uofu-emb-26/Autonomous-Sailboat/docs/main.pdf

# ALAN: Autonomous Long-Range Aquatic Navigation Vessel

(The V is silent.)

Charbel Salloum, Connor Stevens, Corbin Barney, Harrison LeTourneau, Jared Pratt

Abstract—This paper describes the design and implementation of ALAN (Autonomous Long-Range Aquatic Navigation), a semi-autonomous sailboat intended for longduration operation in open water environments. The vessel navigates between user-defined waypoints using windpowered propulsion, requiring no human intervention during transit. This work addresses the challenge of building a low-cost autonomous sailing platform suitable for environmental monitoring and oceanographic data collection, where conventional motorized vessels are limited by fuel capacity and operational cost. The mechanical, electrical, and software subsystems are presented, along with an analysis of associated risks and mitigation strategies.

I. INTRODUCTION

Autonomous marine vessels have the potential to revolutionize environmental monitoring, oceanographic data collection, and maritime logistics by eliminating the need for crewed expeditions. However, existing solutions are often prohibitively expensive, reliant on motor-driven propulsion with limited range, or lack the robustness required for extended blue water operation. A low-cost, sail-powered autonomous vessel would enable persistent ocean presence for data collection without the fuel constraints and maintenance overhead of motorized platforms.
Several approaches to autonomous sailing have been explored in both academic and commercial domains. The SailBot competition community has produced numerous small-scale autonomous sailboats, typically using cloth sails with servo-actuated sheets. Commercial efforts such as Saildrone employ rigid wingsails on large platforms for ocean research. University projects have explored various hull configurations, sail types, and control algorithms ranging from simple reactive controllers to machine learning approaches.
Prior autonomous sailboat projects have demonstrated the viability of GPS waypoint navigation combined with wind-aware path planning. The self-trimming wingsail concept, where a tail vane provides passive torque to rotate the main sail element, has been shown to minimize power consumption compared to motor-actuated sail systems. Trimaran hull designs offer superior stability over monohulls, which is critical for sensor platforms that must remain upright in varying sea states.
ALAN (Autonomous Long-Range Aquatic Navigation) is a semi-autonomous trimaran sailboat that navigates between user-defined waypoints without human intervention. The vessel employs a self-trimming rigid wingsail for propulsion, minimizing power draw while maximizing aerodynamic efficiency. A dual-core STM32H755 microcontroller running FreeRTOS manages real-time sensor fusion (GPS, IMU, magnetometer, wind vane) and control loops for rudder actuation. Long-range communication is achieved via LoRa radio at 915 MHz, enabling telemetry uplink and route update downlink from a ground station.
The scope of this project includes:
- Hull design and fabrication
- Keel and rudder construction
- Rigid wingsail with self-trimming mechanism
- Sensor integration for navigation and orientation
- Long-range wireless communication
- Embedded firmware for autonomous waypoint navigation
Excluded from scope are solar charging, full blue-water endurance testing, and machine-learning-based control. At Demo Day, the vessel will demonstrate autonomous navigation between a series of waypoints on open water (This will be done before hand and displayed using video).

II. SAFETY, GLOBAL, SOCIETAL, ETHICAL CONSIDERATIONS

The ALAN vessel operates autonomously on open water, presenting potential hazards to other watercraft, swimmers, and marine wildlife. To mitigate collision risk, the vessel will be limited to small, controlled bodies of water during testing and will transmit its GPS position continuously via LoRa for ground station monitoring. The vessel’s low speed (sail-powered) and small size reduce the severity of any potential impact. Emergency recovery procedures allow the ground station operator to override autonomous control at any time.
An autonomous sailboat is inherently environmentally friendly compared to motor-driven alternatives. Wind propulsion produces zero emissions and zero noise pollution underwater. The vessel uses a lithium-ion battery only for electronics, not propulsion, minimizing energy consumption. Materials selection (fiberglass, stainless steel, PLA) avoids toxic substances that could leach into water.
Autonomous ocean monitoring platforms could democratize marine research by reducing the cost of data collection expeditions. Developing nations with extensive coastlines but limited research budgets could benefit significantly from low-cost autonomous sailing platforms. However, care must be taken to ensure that such technology is not misused for illicit activities (e.g., smuggling) or deployed in protected marine areas without proper authorization.
The project demonstrates that autonomous sailing vessels can be constructed at a fraction of the cost of commercial alternatives. Currently the only custom part is the hull and its associated components. By using offthe-shelf components (STM32 dev boards, commodity sensors, etc.), the total bill of materials remains accessible to other university teams and hobbyist developers. As engineers, the team has an obligation to ensure the vessel cannot cause harm to people or the environment. This includes implementing fail-safe behaviors (returnto-home on communication loss), clearly marking the vessel as unmanned, and operating only in permitted waterways. Data collected by onboard sensors will be handled responsibly, and the communication protocol will not interfere with other ISM band users beyond regulatory limits.

III. MECHANICAL TASKS

A. Hull

The hull is a trimaran design with a displacementtype main hull (vaka) and two outrigger hulls (amas) connected by arms. The trimaran configuration provides superior stability—the amas act as counterbalances during heeling, preventing capsize.
Fabrication: The hull is manufactured via fiberglass wet layup in a two-part female mold (bow and stern halves, bolted together). The mold is 3D-printed in standard PLA and surface-finished with Rustoleum filler primer, SprayMax 2K topcoat, PARTALL paste wax, and PVA film release agent. Seven sheets of 4 oz plainweave fiberglass cloth are laid up with TotalBoat 5:1 marine epoxy resin, yielding approximately 1 mm wall thickness. The keel mounting area receives additional fiberglass layers and an embedded metal plate bonded with resin for structural reinforcement. The stern is similarly reinforced and fitted with a removable mounting plate for rudder installation. The deck will be fabricated from foam separately and bonded to the hull after curing, allowing for easier access to the interior during assembly. Responsible: Harrison LeTourneau.
Completed Tasks: Hull mold printed and surface-finished; fiberglass layup complete.
Pending Tasks: Mounting hardware installation; deck fabrication and bonding; final sanding; balancing and weight distribution adjustments; static float testing.
B. Sail
The sail is a self-trimming rigid wingsail consisting of a main sail element and a tail mounted aft on a long rod. The tail provides passive aerodynamic torque to rotate the main sail to the optimal angle of attack relative to the wind, minimizing power consumption compared to motor-actuated designs.
Fabrication: The main sail and tail are carved from XPS rigid foam board and covered in fiberglass for durability. The mast is a 3 ft section of 6061 aluminum round tube, mounted on a bearing at the deck to allow free rotation. A servo housed inside the sail body drives tail rotation via wire linkage, providing the self-trimming function.
Responsible: Charbel Salloum, Connor Stevens. Completed Tasks: Foam shaping.
Pending Tasks: Fiberglass covering; servo integration; linkage fabrication; mounting hardware installation.
C. Rudder
The rudder is a spade-type design, chosen for simplicity and ease of modification. It is free-floating (not attached to a skeg), which simplifies construction at the cost of reduced protection from debris impact. Fabrication: The rudder shaft is a 304 stainless steel round bar (0.25 in. × 12 in.) with a 3D printed rudder plate that clamps around the bar. It mounts to the stern via a fore/aft clamp mechanism using two rear mounting plates (Aluminium, 0.065 in.) secured with 1/4-20 hex bolts, nylon insert lock nuts, and stainless washers. Ceramic ball bearings (R188, 1/4 × 1/2 × 3/16 in.) enable free rotation. A DS3218 MG digital servo drives the rudder via a 25-tooth spline-to-1/4-in. shaft coupler. Responsible: Corbin Barney, Jared Pratt.
Completed Tasks: Rudder shaft and plate fabricated. Pending Tasks: Bearing installation; mounting hardware installation; servo integration; linkage fabrication.

D. Keel
The keel is a fin keel with a weighted bulb, chosen for manufacturability and effective center-of-mass control. The fin provides lateral resistance (generating keel lift to counteract sail lift), while the bulb lowers the center of gravity for improved stability.
Fabrication: The keel frame uses 304 stainless steel— a square bar post (0.5 in. × 7 in.) with plate mounting brackets. Two mirrored PLA fins are clamped around the square post and secured with 3/16-in. binding posts. The bulb is a 304 SS round tube (2 in. × 8.5 in.) filled with up to 2 kg of steel balls for ballast. The assembly is wrapped in fiber glass with epoxy resin for structural rigidity.
Responsible: Corbin Barney, Jared Pratt.
Completed Tasks: Keel post and mounting brackets fabricated; fin molds printed.
Pending Tasks: Fin layup; mounting hardware installation.
E. Complete Boat
Integration of hull, keel, rudder, and sail subsystems requires careful alignment of mounting points and verification of center of effort (COE) and center of lateral resistance (CLR) positioning. The COE (where sail lift acts) should be slightly aft of the CLR (where keel lift acts) to achieve weather helm—a natural tendency to turn into the wind that improves stability and safety. We will also need to ensure the rudder has sufficient authority to counteract the aerodynamic forces on the sail, which may require adjusting the rudder size or position after initial testing. Finally, the vessel will be balanced by adjusting the amount of ballast in the keel bulb and the distribution of weight within the hull to achieve the desired waterline, freeboard, and beam rock characteristics.
Testing: Static float tests will verify waterline, freeboard, and draft. Tow tests will confirm rudder authority and directional stability before autonomous operation. Weight distribution will be adjusted by repositioning steel ballast in the keel bulb.
Responsible: ALAN Team.

IV. ELECTRICAL TASKS

A. LoRa
Long-range communication between the vessel and ground station uses LoRa (Long Range) radio operating at 915 MHz in the ISM band (North America). LoRa’s sub-GHz frequency provides significantly greater range than WiFi or Bluetooth due to reduced free-space path loss and better diffraction around obstacles.

Hardware: The vessel carries an Adafruit RFM95W LoRa transceiver breakout board. The ground station uses an Adafruit Feather RP2040 with integrated RFM95 LoRa radio. Both endpoints use 10 dBi whip antennas connected via SMA-to-uFL adapter cables for maximum range. A 5 ft SMA extension cable is used to place the antenna on the top of the vessel’s sail for improved lineof-sight.
Protocol: Uplink (vessel to ground) transmits servo positions, sensor readings, battery state, and GPS coordinates. Downlink (ground to vessel) sends manual control overrides or route/waypoint updates.
Responsible: LoRa Team.
Completed Tasks: LoRa hardware procured; basic communication established.
Pending Tasks: Implement robust packet structure with error checking; integrate LoRa communication into main firmware; test range and reliability in open water conditions.
B. Servos
Two servo motors (DS3218 MG Digital Servo, waterproof, high-torque) actuate the vessel’s control surfaces. The rudder servo controls heading via the rudder shaft coupler. The wingsail servo is housed inside the wingsail to drive tail rotation for self-trimming.
Both servos are powered from the power distribution board at appropriate voltage levels and controlled via PWM signals from the STM32H7.
Responsible: Sensor Team.
Completed Tasks: Servos procured; basic PWM control tested.
Pending Tasks: Implement closed-loop control for rudder and sail angle; test servo response under load conditions.
C. Sensors
The vessel integrates the following sensors for navigation and state awareness:
- GPS (NEO-6 module): Provides latitude/longitude for waypoint navigation. Communicates via UART.
- 9-DoF IMU & Magnetometer (BNO055): Provides spatial orientation (roll, pitch, yaw) and magnetic heading. Used for attitude estimation and heading hold between GPS fixes.
- Wind Vane Direction Sensor (DFRobot): Measures apparent wind direction relative to the vessel. Critical for sail angle optimization and tacking decisions. Communicates via RS485 (adapted to UART via RS485-to-UART converter). Responsible: Sensor Team.

Completed Tasks: Sensors procured; basic communication established; sensors calibrated on the bench. Pending Tasks: Integrate sensor readings into main firmware; implement sensor fusion for accurate state estimation; test sensor performance in marine environment.

D. MCU
The central processor is the STM32H755ZIT6, a dual-core microcontroller featuring a Cortex-M7 core (480 MHz) and a Cortex-M4 core (240 MHz). Two development boards are available for development and a spare.
Architecture: The CM7 core handles real-time control loops (sensor fusion, PID control, servo actuation) and will run on FreeRTOS. The CM4 core handles communication (LoRa packet assembly/parsing, telemetry logging) and runs on bare metal. The two cores communicate via shared memory and inter-core interrupts. Firmware: Written in C using STM32 HAL drivers. The project uses CMake for build management. Responsible: Embedded Team.
Completed Tasks: Basic FreeRTOS setup on CM7; CM7 sensor reading and control loop tested; CM4 LoRa communication tested.
Pending Tasks: Optimize task scheduling and inter-core communication.
E. RC Boat
To prove the functionality of the mechanical and electrical subsystems before autonomous integration, we will build and equip the boat with a manual override and RC system. This will allow us to test the hull, keel, rudder, and sail in real-world conditions while manually controlling the vessel via LoRa communication. The RC system will be integrated with the existing servos and power distribution, allowing us to switch between manual and autonomous control modes for testing and demonstration purposes at a later stage.
Responsible: ALAN Team.
Completed Tasks: RC components procured; basic manual control tested outside of the boat.
Pending Tasks: Integrate RC control with existing servos and power system in the boat; test manual control in open water conditions.
V. SOFTWARE TASKS
A. Positioning
The positioning subsystem fuses GPS and IMU data to determine the vessel’s position and heading at all times. GPS provides absolute position at low update rates, while the IMU and magnetometer provide high-rate heading and attitude information between GPS fixes. Implementation: A complementary filter combines GPS position with integrated IMU acceleration and magnetometer heading to produce a smooth, accurate state estimate. The system must handle GPS dropouts gracefully by dead-reckoning from IMU data until GPS lock is reacquired.
Responsible: Corbin Barney, Harrison LeTourneau. Completed Tasks: None.
Pending Tasks: Implement sensor fusion algorithm; test positioning accuracy in static and dynamic conditions; optimize for low-latency updates.
B. Self Trimming Wingsail
The software component of the self-trimming wingsail manages the servo that controls the tail angle. The tail angle is adjusted based on the apparent wind direction to maintain an optimal angle of attack for the main sail, maximizing propulsion efficiency while minimizing power consumption. The control loop runs continuously using a PID, adjusting the tail angle in response to changes in wind direction and vessel heading. Implementation: The wind vane sensor reading is compared with the current sail angle (estimated from servo position and IMU yaw) to determine if the tail servo requires adjustment. The control loop runs on the CM7 core as a FreeRTOS task.
Responsible: Connor Stevens, Charbel Salloum. Completed Tasks: None.
Pending Tasks: Implement PID control loop for tail servo; test response to changing wind conditions; optimize for stability and responsiveness.
C. Path Planning
The path planning subsystem computes a route between the current position and the next waypoint, accounting for wind direction and the no-sail zone (±45 into the wind).
Implementation: When the direct path to a waypoint falls within the no-sail zone, the planner generates a tacking sequence—a series of close-hauled legs alternating between port and starboard tack. A state machine manages transitions between sailing states: close-hauled, beam reach, broad reach, running, tacking, and jibing. Waypoint arrival is determined by a configurable radius threshold around the target GPS coordinate. Responsible: Charbel Salloum, Jared Pratt. Completed Tasks: None.
Pending Tasks: Implement path planning algorithm; test route generation under various wind conditions; optimize for efficiency and safety.

D. Emergency Recovery
The emergency recovery subsystem provides fail-safe behavior when anomalous conditions are detected, including communication loss, low battery, sensor failure, or geofence violation.
Implementation: On communication timeout (configurable threshold), the vessel enters return-to-home mode, navigating back to its launch waypoint. On critically low battery, the vessel furls the sail (luffs into the wind) to minimize drift and transmits distress telemetry at increased frequency. GPS coordinates are continuously logged to non-volatile storage for post-incident recovery. Responsible: Corbin Barney.
Completed Tasks: None.
Pending Tasks: Implement emergency state machine; test return-to-home behavior; validate low-battery response.
E. Ground Station Interface
The ground station interface allows remote monitoring and control of the vessel via LoRa communication. The operator can view real-time telemetry, update waypoints, or trigger manual control overrides.
Implementation: A comprehensive GUI displays vessel status, including GPS position on a map, heading, speed, battery level, and sensor readings. The operator can input new waypoints or commands that are transmitted to the vessel via LoRa downlink. The operator will be able to interact with the vessel using GUI inputs or CLI commands sent through a terminal interface in the ground station program.
Responsible: Harrision LeTourneau, Jared Pratt. Completed Tasks: Preliminary LoRa communication established.
Pending Tasks: Implement ground station interface; test GUI and CLI interactions; validate LoRa communication.
F. Autonomous Sailboat
The top-level autonomous control integrates all software subsystems: positioning, self-trimming wingsail control, path planning, and emergency recovery into a cohesive mission execution framework. Implementation: The mission controller accepts a sequence of GPS waypoints (uploaded via LoRa or preloaded) and sequences through them, invoking the path planner for each leg. Telemetry is continuously streamed to the ground station. The operator can inject new waypoints, trigger return-to-home, or assume manual control at any time via the LoRa downlink. Responsible: ALAN Team.

Completed Tasks: None.
Pending Tasks: Implement mission controller; test integration of all subsystems; validate overall autonomous behavior.

VI. RISKS

A. Mechanical Risks
Hull Integrity Failure: The fiberglass hull may develop cracks or delamination during operation, leading to water ingress and sinking. Mitigation: apply multiple layers of fiberglass (7 sheets, approximately 1 mm thickness) with additional reinforcement at stress points (keel mount, stern). Perform water submersion tests before open-water deployment.
Keel Detachment: The fin keel with steel-filled bulb experiences significant lateral forces during sailing. If the mounting bracket fails, the vessel loses stability and capsizes. Mitigation: use 304 stainless steel plate for mounting brackets with four 1/4-in bolts and lock nuts; reinforce the hull keel mount area with extra fiberglass layers and an embedded metal plate.
Rudder Bearing Seizure: Salt water and debris may cause the rudder shaft bearings to seize, resulting in loss of steering. Mitigation: use ceramic ball bearings (R188) rated for marine environments; apply marine silicone grease; design for easy field replacement.
Mast/Sail Damage: High winds could overload the wingsail structure, snapping the mast or cracking the foam-core sail panels. Mitigation: design for expected wind conditions with safety margin; the self-trimming mechanism naturally feathers the sail in excessive wind.
B. Electrical Risks
Water Ingress to Electronics: Despite the sealed enclosure (Pelican M60), wave action or submersion during capsize could introduce water to the electronics bay. Mitigation: use IP-rated connectors for all cable pass-throughs; apply conformal coating to PCBs; include moisture-indicating desiccant packs.
Battery Failure: The 3S LiPo battery (11.1 V nominal) poses fire and explosion risk if overcharged, overdischarged, or punctured. Mitigation: integrate a dedicated BMS (Battery Management System) that prevents overcharge and deep discharge; house battery in a fireresistant compartment within the Pelican case.
LoRa Communication Loss: Environmental interference or antenna damage could sever the communication link. Mitigation: use high-gain 10 dBi antennas; implement autonomous return-to-home behavior on communication timeout; store mission parameters locally so the vessel can continue operation without uplink.

Servo Failure: The rudder or sail servo may burn out under sustained load. Mitigation: select waterproof, high-torque servos (20 kg-cm) rated for continuous duty; implement current monitoring to detect stall conditions.

C. Software Risks
Sensor Fusion Divergence: GPS, IMU, and magnetometer readings may conflict due to electromagnetic interference or sensor drift, causing incorrect heading calculations. Mitigation: implement complementary filtering; validate sensor readings against expected ranges; fall back to GPS-only navigation if IMU data is unreliable.
Real-Time Deadline Miss: FreeRTOS task scheduling may fail to meet control loop deadlines under heavy sensor polling load, causing unstable rudder behavior. Mitigation: assign appropriate task priorities; profile worst-case execution times; use the dual-core STM32H755 to distribute workload across CM7 (control) and CM4 (communication/telemetry) cores.
Path Planning Edge Cases: The navigation algorithm may fail to handle situations such as sailing directly into the no-sail zone (±45◦
into the wind), requiring tacking maneuvers that the path planner must handle correctly. Mitigation: implement a state machine with explicit tacking/jibing states; test extensively in simulation before on-water trials.
Firmware Update Corruption: Over-the-air updates via LoRa could introduce corrupted firmware. Mitigation: implement CRC validation on received firmware images; maintain a known-good fallback firmware partition.

VII. SCHEDULE

VIII. BILL OF MATERIALS

IX. CONCLUSION
The ALAN project demonstrates the feasibility of constructing a low-cost autonomous sailboat using accessible manufacturing techniques and off-the-shelf electronic components. By combining a trimaran hull design with a self-trimming rigid wingsail, the vessel achieves propulsion efficiency without the power consumption of motor-driven sail actuation. The use of a dual-core STM32H755 running FreeRTOS provides the real-time performance required for sensor fusion and control, while LoRa radio enables long-range communication suitable for open-water operation.
Key contributions of this project include: a fiberglass hull manufacturing process using 3D-printed molds accessible to university fabrication labs; a modular mechanical design allowing independent development and

TABLE I
PROJECT MILESTONES
Milestone | Responsible | Deliverable
Hull mold printed and surface-finished | Harrison LeTourneau | Smooth, release-coated female mold
Hull fiberglass layup complete | Harrison LeTourneau | Cured fiberglass hull shell
Keel and rudder fabri-cated | Team (Mechani-cal) | Assembled keel with bulb; rudder with shaft and bearings
Wingsail fabricated | Charbel Salloum, Connor Stevens | Foam-core fiberglass sail with tail mecha-nism
Electronics integration | Harrison LeTourneau, Jared Pratt | STM32H7 with all sensors and servos wired
LoRa communication verified | Harrison LeTourneau, Jared Pratt | Bidirectional link between vessel and ground station
Firmware: sensor polling and control loops | Corbin Barney | FreeRTOS tasks run-ning on CM7 core
Firmware: navigation and path planning | Corbin Barney | Waypoint following with tacking logic
Full system integration | All | Complete vessel with all subsystems operational
On-water testing and Demo Day | All | Autonomous waypoint navigation demonstration

testing of keel, rudder, and sail subsystems; and an embedded software architecture distributing navigation and communication across dual processor cores. Future work includes integration of solar charging for extended mission duration, implementation of machinelearning-based path planning for complex wind conditions, full blue-water endurance testing, and expansion of the sensor suite for environmental data collection applications. The modular design of ALAN facilitates iterative improvement across all subsystems.

APPENDIX A
SAILBOAT ANATOMY

A sailboat consists of several key structural and functional components:
Directions & Regions: Fore (forward) and aft (rearward) define the longitudinal axis. Bow is the front of the hull; stern is the rear. Starboard is the right side when facing forward; port is the left. Outboard refers to the exterior of the hull; inboard refers to the interior. Hull: The main body of the vessel providing buoyancy. Hull types include displacement hulls (slower, more stable) and planing hulls (faster, less stable). ALAN uses a trimaran configuration: a central vaka (main hull)

TABLE II
BILL OF MATERIALS – MECHANICAL
Category | Item | Status | Contact | Notes
Rudder
Rudder - Shaft | Shaft Bearing | | R188 Ceramic 1/4 x 1/2 x 3/16 in.
Rudder - Shaft | Rudder Shaft | | SS 304 Round Bar (0.25 in. x 12 in.)
Rudder - Shaft | Rudder Plate | | 304 SS plate 0.25 in.
Rudder - Shaft | Rudder Cross Bolt, Barrel Nut | Delivered | 3/16 in. x 3/4 in. Alu-minum Binding Post
Rudder - Mount-ing | Mounting Bolts | Delivered | 1/4-20 x 1-1/2 in. Zinc Plated Hex Bolt
Rudder - Mount-ing | Mounting Nuts | Delivered | 1/4-20 SS Nylon Insert Stop Nut
Rudder - Mount-ing | Mounting Washers | Delivered | 1/4 in. SS Flat Washer
Rudder - Mount-ing | Rear Mounting Plate | | 304 SS plate 0.25 in.
Rudder - Servo | Marine silicone grease (1 oz)
Rudder - Servo | Marine epoxy resin (small kit)
Rudder - Servo | Servo-Shaft Coupler | Ordered | 25 Tooth Spline to 1/4 in. Round Bore
Rudder - Servo | Rudder Servo | Delivered | DS3218 MG Digital Servo
Rudder - Servo | Servo Bolt | Delivered | M4-0.7x30mm Hex Bolt
Rudder - Servo | Servo Bolt Nut | | M4 SS Lock Nut
Rudder | PLA Filament | Lab Provided
Keel
Keel | Carbon fiber cloth | | Cover for completed as-sembly
Keel | Epoxy resin kit | | For composite layup
Keel - Structure | Keel Post | | SS 304 Square Bar (0.5 in. x 7 in.)
Keel - Structure | Keel Mounting Bracket | | 304 SS plate 0.25 in.
Keel - Structure | Mounting Bolts | Delivered | 1/4-20 x 1-1/2 in. Zinc Plated Hex Bolt
Keel - Structure | Mounting Nuts | Delivered | 1/4-20 SS Nylon Insert Stop Nut
Keel - Structure | Mounting Washers | Delivered | 1/4 in. SS Flat Washer
Keel - Structure | Keel Bulb | | SS 304 Round Tube (2 in. x 8.5 in.)
Keel - Structure | Steel Balls | Lab Provided | Ballast
Keel - Fin | Keel Cross Bolt, Barrel Nut | Delivered | 3/16 in. x 3/4 in. Alu-minum Binding Post
Keel - Fin | PLA Filament | Lab Provided
Mold
Mold | Standard PLA Bambu filament | Lab Provided
Mold | Rustoleum Filler/Sandable Primer | Purchased
Mold | SprayMax 2K Topcoat High Gloss Black | ECE Request
Mold | PARTALL Paste #2 Wax | Delivered
Mold | PARTALL Film #10 PVA | ECE Request
Hull – Glassing
Hull - Glassing | Fiberglass Cloth Roll | ECE Request | Harrison LeTourneau | 4 oz plain weave, 50 in. wide
Hull - Glassing | Econostitch Peel Ply | Delivered | Harrison LeTourneau
Hull - Glassing | TotalBoat 5:1 Marine Epoxy Kit | ECE Request | Harrison LeTourneau

Hull – Tools
Hull - Tools | Chip Paint Brushes (1 in., 24 pack) | Delivered | Harrison LeTourneau
Hull - Tools | Resin Epoxy Mixing Cups (50 pcs) | Delivered | Harrison LeTourneau
Hull - Tools | 3M Dynatron Spreaders (3 pack) | Delivered | Harrison LeTourneau
Hull - Tools | Wet/Dry Sandpaper Assortment | Purchased | Harrison LeTourneau

Hull – PPE

TABLE III
BILL OF MATERIALS – SAIL & ELECTRONICS
Category | Item | Status | Contact | Notes
Rigid Sail
Rigid Sail | 6061 Aluminum Mast (3 ft) | Connor Stevens
Rigid Sail | 6061 Aluminum Mast (alt. source) | Connor Stevens | Metal Supermarket
Rigid Sail | Foam (XPS Rigid Board) | Charbel Salloum
Rigid Sail | Cardboard | Charbel Salloum
Electronics
Electronics | STM32H7 Dev Board | Delivered | Harrison LeTourneau
Sensors | Wind Vane Direction Sensor | Delivered
Sensors | 9-DoF IMU & Magnetometer | Delivered | | BNO055
Sensors | GPS Module | Delivered | | NEO-6
Electronics | Solar Panel (10 W, 12 V)
Electronics | LiPo Battery (11.1 V, 3S) | | Jared Pratt
Electronics | Buck Converters (DC-DC)
Electronics | Pelican M60
Electronics | High-Torque Servo (20 kg-cm) | | | Waterproof
Electronics | 5 V and 12 V PDB
Electronics | RS485 to UART Adapter
Electronics | Battery BMS | | Jared Pratt | Overcharge/discharge pro-tection

Electronics – Wireless
Wireless | Adafruit RFM95W LoRa (915 MHz) | Delivered | Harrison LeTourneau
Wireless | Adafruit Feather RP2040 w/ RFM95 | Lab Provided | Harrison LeTourneau
Wireless | uFL SMT Antenna Connector | Delivered | Harrison LeTourneau
Wireless | SMA to uFL Adapter Cable | | Harrison LeTourneau | Comes with antennas
Wireless | 10 dBi Whip Antenna w/ Adapters | Delivered | Jared Pratt
Wireless | SMA Male-Female Extension (5 ft) | Delivered | Jared Pratt
Miscellaneous
Misc | S6005-2RS Bearing | 25 mm ID, deck mast part- ner

with two amas (outriggers) connected by arms, providing
exceptional stability.
Keel: A fin extending below the hull that provides lateral resistance, preventing the boat from sliding sideways under sail force. Keel types include full keels (more stable, shallow draft, higher drag) and fin keels (more efficient, deeper draft). Sub-forms include squared, rounded, and bulb profiles. ALAN uses a fin keel with a bulb for stability and low center of mass.
Rudder: A movable fin at the stern used for steering. Balanced rudders are easy to turn but do not self-center; unbalanced rudders self-center but require more force. Styles include spade (free-floating, simple) and skegmounted (more protected, more stable). ALAN uses a spade rudder for simplicity.
Mast & Sail: The mast is a vertical spar supporting the sail. Sail materials include cloth (cheaper, traditional, more wear) and rigid (durable, more efficient lift). Autonomous boats favor rigid sails for durability.

Self-Trimming Wingsail: A rigid sail with a main element and a tail (wind vane) on a long rod aft of the pivot point. The tail provides passive aerodynamic torque to rotate the sail to the optimal angle. This design minimizes power consumption at the cost of higher mechanical complexity and wind-dependent response time. Freeboard & Draft: Freeboard is the distance from the waterline to the deck. Draft is the distance from the waterline to the lowest point of the keel.

APPENDIX B
SAILBOAT PHYSICS
Lift Forces: A sailboat is driven by two opposing lift forces. The sail generates lift from the wind, directed roughly perpendicular to the sail surface. The keel generates an opposing lateral lift force from the water. The net effect of these two forces propels the boat forward. Point of Sail: The point of sail is the boat’s angle relative to the wind direction. The angle of attack is the sail’s angle relative to the apparent wind. The optimal angle of attack depends on the point of sail. The no-sail zone encompasses approximately ±45 directly into the wind (90° total arc), where the sail cannot generate useful lift.
Rudder Control: The rudder modifies the interaction between sail and keel forces to change heading. Turning the rudder toward the wind decreases the effective keel force, causing the boat to turn away from the wind (bear away). Turning the rudder away from the wind increases the effective keel force, causing the boat to turn into the wind (head up).
Center of Effort (COE) and Center of Lateral Resistance (CLR): The COE is the point where the resultant sail lift force acts. The CLR is the point where the resultant keel/hull lateral resistance acts. When the COE is positioned slightly aft of the CLR, the boat exhibits weather helm—a natural tendency to turn into the wind. Weather helm is desirable because it provides inherent stability: if the helm is released, the boat rounds up into the wind and the sails luff, bringing the boat to a safe stop rather than accelerating uncontrolled.

APPENDIX C
TEAMS
We divided our group into several sub-teams in order to better divide work. In addition to this, we also contracted additional people for specific tasks.
A. Additional Contributors
Adam Welsh is a Computer Engineering student at the University of Utah that assisted the LoRa team in development.
Derek Tinoco is a Computer Scientist that assisted in the early sensor integration process.
Aliou Tippett is a student at the University of Utah that assisted the LoRa team in development.
B. Sub-Teams
LoRa Team: Harrison LeTourneau, Jared Pratt, Adam Welsh, Aliou Tippett. This team was responsible for the design, implementation, and testing of the LoRa communication system between the vessel and the ground station.
Sensor Team: Corbin Barney, Charbel Salloum, Connor Stevens, Derek Tinoco. This team was responsible for selecting, integrating, and testing the various sensors (GPS, IMU, wind vane) used for navigation and state awareness.
ALAN Team: Corbin Barney, Charbel Salloum, Connor Stevens, Harrison LeTourneau, Jared Pratt. This team was responsible for the overall integration of the vessel, including mechanical assembly, firmware development, and on-water testing.
Embedded Team: Corbin Barney, Charbel Salloum, Connor Stevens, Harrison LeTourneau, Jared Pratt, Derek Tinoco, Adam Welsh, Aliou Tippett. This team was responsible for the preliminary test benches used to test the various components of the vessel, including the LoRa communication system and the sensor suite.

REFERENCES

[1] source, (date of access). title (date of release)
