uofu-emb-26/Autonomous-Sailboat/(commit log)

2026-03-23 Add Harrison LeTourneau to Antenna Team section
2026-03-31 incomplete button led
2026-04-07 added lora.c and lora.h, set up outline for SPI and RM95w config for ~20byte packets. have lora module wired to SPI1 peripheral.
2026-04-08 added SPI config to hal msp and called it in main.c
2026-04-08 added hal spi libraries
2026-04-08 call to spi init for RFM95W config
2026-04-08 added some info to send things and also added reset pin
2026-04-09 bunch of test prints added for UART testing
2026-04-09 updated where debug screen COM port is initialized to allow for printf to work in init functions.
2026-04-09 working wind vane with servo rotation. Need to clean up debugging and comment out sections
2026-04-10 Added some I2C init
2026-04-14 added clarifying comments to what pins are used for I2C for BNo055
2026-04-17 Moved from polling driven transmit to interrupt driven. TIM6 is configured to fire every second. Uncommented #define HAL_TIM_MODULE_ENABLED
    volatile var tx_flag is set by the isr from tim6 and used by main.
    main uses WFI (later will be triggered by tx interrupt on timer OR rx timer on the gpio exti interrupt)
    init necesary stuff in main
2026-04-22 Wrote SOME code for the GPS. Not sure on correctness
    [gps_parser.h, sensorGPS.c]
2026-04-22 removed Interrupt code and removed raw gps byte
2026-04-22 fixed a bunch of underliying bugs
    [gps_parser.h, main.c, sensorGPS.c, sensorMagnetometer.c, sensorMagnetometer.h]
2026-04-22 added print for vector read
2026-04-22 got the magnetometer working
2026-04-23 correctedstring parsing bugs in sensorGPS, need to add printf statements
    [gps_parser.h, sensorGPS.c]
2026-04-23 added printout statements for gps fields
2026-04-26 Initial Commit with all code required to switch between all servo tasks, gps runs in background. Not formally tested just with printfs.
2026-04-26 Updated wind/sail headers and added wind tracking sail handler to servoSail
2026-04-26 Servo correctly driven by all peripherals. Button task switching works about 99% of the time. Some intrmittent communication errors or rtos freezes.
    [sensorMagnetometer.c, sensorWind.c, sensorWind.h, servoRudder.c, servoSail.c, servoSail.h]
2026-04-26 Clamped servo to +-45
2026-04-26 clamped servo rudder and turned crc on in lora.c
2026-04-26 clamped servo angle to 45+-
2026-04-26 fixed mission successful logic in sensonrGPSHandler
    [sensorGPS.c]
2026-04-27 cleanup of the prints
2026-04-27 readded gps prints
2026-04-27 get these out of the git track
2026-04-28 Added fucntion descriptions, and refined/added comments (#3)
    Squashing and merging the comment commit to resolve git branching/divergence error.
    [button.c, button.h, main.c, sensorMagnetometer.c, sensorMagnetometer.h, sensorWind.c, sensorWind.h, servoSail.c]
2026-04-30 Changed cm4 linker to section off sector 7 for write/readable flash memeory. Removed button task switching mechanisms from all sensor files and reset butto just turn on LED. Added flash.c which allow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
    [button.c, flash.c, flash.h, main.c, sensorMagnetometer.c, sensorMagnetometer.h, sensorWind.c, servoRudder.c]
2026-04-30 current state of latex docs
2026-08-28 put an actual schematic into the program
    [Autonomous_Sailboat.kicad_pcb, Autonomous_Sailboat.kicad_sch]
2026-08-28 started the battery code but I'm kinda lost
2026-08-28 schematic update
    [Autonomous_Sailboat.kicad_sch]
2026-08-31 added teh missing ADC drivers
2026-08-31 still missing a few files
    [battery.c]
2026-09-01 naive battery monitor
    [Autonomous_Sailboat.kicad_sch]
2026-09-01 Now the battery monitor is reading correctly
    [Autonomous_Sailboat.kicad_sch]
2026-09-01 switched to an averaging algorithm
